HeitorCand/_INTELI_dino_controller/models/evaluation.txt

              precision    recall  f1-score   support

       ruido       0.75      0.90      0.82        10
       pular       1.00      0.90      0.95        10
      abaixa       0.75      0.67      0.71         9

    accuracy                           0.83        29
   macro avg       0.83      0.82      0.82        29
weighted avg       0.84      0.83      0.83        29

Confusion matrix (rows=true, cols=pred), order ['ruido', 'pular', 'abaixa']:
[[9 0 1]
 [0 9 1]
 [3 0 6]]
