HeitorCand/_INTELI_dino_controller/firmware/dino_voice_controller/dsp_tables.h

// Gerado automaticamente por training/export_c_dsp.py — NAO EDITAR A MAO.
// Tabelas do pipeline de DSP (janela Hann, filtros mel, matriz DCT) —
// devem ficar em sincronia com training/dsp.py.
#pragma once

#define DSP_N_FFT 512
#define DSP_N_BINS 257
#define DSP_HOP_LENGTH 256
#define DSP_N_MELS 26
#define DSP_N_MFCC 11
#define DSP_N_FRAMES 61
#define DSP_CLIP_LENGTH 16000

static const float DSP_HANN_WINDOW[512] = {0.00000000f, 0.00003780f, 0.00015118f, 0.00034013f, 0.00060463f, 0.00094463f, 0.00136008f, 0.00185091f, 0.00241706f, 0.00305844f, 0.00377495f, 0.00456648f, 0.00543291f, 0.00637411f, 0.00738995f, 0.00848026f, 0.00964488f, 0.01088363f, 0.01219634f, 0.01358279f, 0.01504278f, 0.01657609f, 0.01818249f, 0.01986173f, 0.02161357f, 0.02343773f, 0.02533393f, 0.02730190f, 0.02934134f, 0.03145194f, 0.03363337f, 0.03588531f, 0.03820742f, 0.04059934f, 0.04306072f, 0.04559118f, 0.04819034f, 0.05085782f, 0.05359319f, 0.05639606f, 0.05926599f, 0.06220255f, 0.06520531f, 0.06827380f, 0.07140756f, 0.07460611f, 0.07786898f, 0.08119567f, 0.08458568f, 0.08803850f, 0.09155359f, 0.09513044f, 0.09876850f, 0.10246722f, 0.10622604f, 0.11004440f, 0.11392171f, 0.11785739f, 0.12185084f, 0.12590148f, 0.13000865f, 0.13417177f, 0.13839021f, 0.14266330f, 0.14699043f, 0.15137093f, 0.15580413f, 0.16028938f, 0.16482598f, 0.16941325f, 0.17405050f, 0.17873703f, 0.18347214f, 0.18825510f, 0.19308519f, 0.19796169f, 0.20288384f, 0.20785092f, 0.21286216f, 0.21791682f, 0.22301412f, 0.22815330f, 0.23333357f, 0.23855416f, 0.24381429f, 0.24911314f, 0.25444993f, 0.25982383f, 0.26523405f, 0.27067977f, 0.27616015f, 0.28167439f, 0.28722161f, 0.29280102f, 0.29841176f, 0.30405295f, 0.30972379f, 0.31542337f, 0.32115087f, 0.32690543f, 0.33268613f, 0.33849216f, 0.34432256f, 0.35017651f, 0.35605314f, 0.36195150f, 0.36787075f, 0.37380999f, 0.37976828f, 0.38574475f, 0.39173850f, 0.39774862f, 0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
0246722f, 0.09876850f, 0.09513044f, 0.09155359f, 0.08803850f, 0.08458568f, 0.08119567f, 0.07786898f, 0.07460611f, 0.07140756f, 0.06827380f, 0.06520531f, 0.06220255f, 0.05926599f, 0.05639606f, 0.05359319f, 0.05085782f, 0.04819034f, 0.04559118f, 0.04306072f, 0.04059934f, 0.03820742f, 0.03588531f, 0.03363337f, 0.03145194f, 0.02934134f, 0.02730190f, 0.02533393f, 0.02343773f, 0.02161357f, 0.01986173f, 0.01818249f, 0.01657609f, 0.01504278f, 0.01358279f, 0.01219634f, 0.01088363f, 0.00964488f, 0.00848026f, 0.00738995f, 0.00637411f, 0.00543291f, 0.00456648f, 0.00377495f, 0.00305844f, 0.00241706f, 0.00185091f, 0.00136008f, 0.00094463f, 0.00060463f, 0.00034013f, 0.00015118f, 0.00003780f, 0.00000000f};
static const float DSP_BIN_FREQS[257] = {0.00000000f, 31.25000000f, 62.50000000f, 93.75000000f, 125.00000000f, 156.25000000f, 187.50000000f, 218.75000000f, 250.00000000f, 281.25000000f, 312.50000000f, 343.75000000f, 375.00000000f, 406.25000000f, 437.50000000f, 468.75000000f, 500.00000000f, 531.25000000f, 562.50000000f, 593.75000000f, 625.00000000f, 656.25000000f, 687.50000000f, 718.75000000f, 750.00000000f, 781.25000000f, 812.50000000f, 843.75000000f, 875.00000000f, 906.25000000f, 937.50000000f, 968.75000000f, 1000.00000000f, 1031.25000000f, 1062.50000000f, 1093.75000000f, 1125.00000000f, 1156.25000000f, 1187.50000000f, 1218.75000000f, 1250.00000000f, 1281.25000000f, 1312.50000000f, 1343.75000000f, 1375.00000000f, 1406.25000000f, 1437.50000000f, 1468.75000000f, 1500.00000000f, 1531.25000000f, 1562.50000000f, 1593.75000000f, 1625.00000000f, 1656.25000000f, 1687.50000000f, 1718.75000000f, 1750.00000000f, 1781.25000000f, 1812.50000000f, 1843.75000000f, 1875.00000000f, 1906.25000000f, 1937.50000000f, 1968.75000000f, 2000.00000000f, 2031.25000000f, 2062.50000000f, 2093.75000000f, 2125.00000000f, 2156.25000000f, 2187.50000000f, 2218.75000000f, 2250.00000000f, 2281.25000000f, 2312.50000000f, 2343.75000000f, 2375.00000000f, 2406.25000000f, 2437.50000000f, 2468.75000000f, 2500.00000000f, 2531.25000000f, 2562.50000000f, 2593.75000000f, 2625.00000000f, 2656.25000000f, 2687.50000000f, 2718.75000000f, 2750.00000000f, 2781.25000000f, 2812.50000000f, 2843.75000000f, 2875.00000000f, 2906.250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
 1.77091205f, 1.77091205f, 0.24107336f, -1.49702156f, -1.94188368f, -0.70920980f, 1.13612950f, 2.00000000f, 1.13612950f, -0.70920980f, -1.94188368f, -1.49702156f, 0.24107336f, 1.77091205f, 1.71156251f, -0.12075699f, -1.82379973f, -1.57436693f, 0.36051008f, 1.90944171f, 1.41421354f, -0.59500611f, -1.96723986f, -1.23343778f, 0.82082564f, 1.99635112f, 1.03467560f, -1.03467560f, -1.99635112f, -0.82082564f, 1.23343778f, 1.96723986f, 0.59500611f, -1.41421354f, -1.90944171f, -0.36051008f, 1.57436693f, 1.82379973f, 0.12075699f, -1.71156251f, 1.64596772f, -0.47863132f, -1.98541772f, -0.92944634f, 1.32624531f, 1.87003243f, 0.00000000f, -1.87003243f, -1.32624531f, 0.92944634f, 1.98541772f, 0.47863132f, -1.64596772f, -1.64596772f, 0.47863132f, 1.98541772f, 0.92944634f, -1.32624531f, -1.87003243f, -0.00000000f, 1.87003243f, 1.32624531f, -0.92944634f, -1.98541772f, -0.47863132f, 1.64596772f};
