HeitorCand/_INTELI_dino_controller/firmware/dino_voice_controller/model_weights.h

// Gerado automaticamente por training/export_c_model.py — NAO EDITAR A MAO.
// Pesos do classificador (14 -> 16 -> 3) exportados de models/model.onnx.
#pragma once

#define MODEL_INPUT_DIM 14
#define MODEL_HIDDEN_DIM 16
#define MODEL_OUTPUT_DIM 3

static const float MODEL_FEATURE_MEAN[14] = {0.06912120f, 0.05374886f, 1060.70336914f, -41.91224289f, 20.66954231f, 3.30957580f, 5.01662731f, 1.32854223f, 1.07099843f, 3.33626580f, 0.09729191f, 2.69106770f, 0.13056268f, 1.40158260f};
static const float MODEL_FEATURE_STD[14] = {0.05550516f, 0.06674842f, 832.20416260f, 71.41362762f, 16.46324539f, 7.28302717f, 4.36978674f, 3.10533094f, 2.97142386f, 2.42597795f, 1.95839226f, 1.97845685f, 1.80596626f, 1.69865310f};
static const float MODEL_W1[224] = {-0.68462336f, 0.83137816f, -0.27663499f, 0.65736639f, -1.14254630f, -1.24790776f, 0.29761100f, 0.75139672f, 0.78998572f, 0.44206744f, -0.39365783f, -0.94104177f, 0.61214894f, 0.19086707f, -0.96814102f, 0.61311495f, 0.59436256f, 0.10916279f, 0.29985192f, -0.23247701f, -0.40611807f, -0.21562888f, 0.30488542f, 0.76631844f, -0.77504510f, -0.56126654f, 0.21959364f, 0.02768652f, 0.42558244f, 0.11142458f, 0.83168095f, -0.30330464f, 1.08849895f, -0.10859705f, -0.19737646f, 0.07138971f, 0.11890364f, 0.55889010f, -0.31737173f, -0.74623841f, 0.20646280f, 0.10793550f, 0.48795804f, -0.16879384f, -0.42175952f, -0.61964291f, 1.21426618f, -0.61936051f, 0.26101136f, 0.03092177f, -0.06524704f, 0.30990130f, -0.41177124f, 1.01031554f, -0.41550484f, 0.67695773f, 0.86868292f, -0.51463675f, 1.13366377f, -0.05458485f, -0.88251406f, 0.44762063f, 0.27979052f, -0.32582387f, -0.16872747f, 0.10479505f, 0.42373091f, -0.97208327f, -0.38683480f, 0.35282680f, 0.57352185f, 0.18639608f, 0.27925628f, -0.48410913f, 0.04929976f, -0.63011038f, -0.60740095f, -0.32758686f, 0.45145875f, -0.52099407f, 0.04641594f, -0.47688428f, 0.53995764f, -0.04050408f, 0.79242593f, -0.04556704f, 0.60421342f, -0.70282650f, 0.00947619f, -0.05764787f, -0.25014800f, -0.40532514f, 0.65974563f, -0.63766855f, -0.09511381f, 0.36447349f, 0.26034635f, -0.34272403f, -0.76957464f, -0.69876343f, -0.70178491f, 0.32221943f, -1.02615774f, 0.45945674f, 0.07316710f, 0.02373385f, 0.07912834f, 0.52190316f, 0.74574751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
static const float MODEL_B2[3] = {0.39390135f, -0.06279805f, -0.24335882f};
