HeitorCand/_INTELI_dino_controller/firmware/dino_voice_controller/feature_extraction.h

// Extração de features (RMS, Zero-Crossing Rate, Spectral Centroid, MFCC),
// espelhando exatamente training/dsp.py e training/features.py em Python —
// mesma FFT de 512 pontos, 26 filtros mel, 11 coeficientes MFCC (ver
// firmware/dsp_tables.h, gerado por training/export_c_dsp.py).
#pragma once

#include <stdint.h>

#include "dsp_tables.h"

#define FEATURE_DIM (1 + 1 + 1 + DSP_N_MFCC)  // RMS + ZCR + centroide + MFCC

// signal deve ter exatamente DSP_CLIP_LENGTH (16000) amostras PCM de 16 bits
// (mesma convenção de um WAV int16 — valor float = amostra / 32768.0).
// outFeatures recebe FEATURE_DIM valores, na ordem
// [RMS, ZCR, centroide, mfcc_0..mfcc_10] — mesma ordem de training/features.py.
void extractFeatures(const int16_t *signal, float outFeatures[FEATURE_DIM]);
