HeitorCand/_INTELI_dino_controller/(commit log)

2026-09-17 Add audio data augmentation (noise, pitch shift, time stretch)
    [augment.py]
2026-09-17 Fix train/test leakage from post-augmentation splitting
    build_dataset augmented each raw clip into 4 correlated variants
    (original + noisy + pitch-shifted + time-stretched) before
    split_dataset randomly partitioned the pooled rows. Augmented
    siblings of the same recording could land on both sides of the
    split, so reported test accuracy reflected near-duplicate leakage
    rather than genuine generalization.
    Restructure training/dataset.py to split at the raw-clip level
    first (split_raw_clips), then only augment the training partition
    (build_features(..., augment=True) for train, augment=False for
    test) via load_raw_clips + build_features. Update train.py's main()
    and training/tests/test_dataset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
    [dataset.py, record_audio.py, train.py]
2026-09-17 Fix code review findings on training pipeline
    - record_audio.py: compute next_clip_index from max existing index + 1
    instead of file count, so deleting a bad take no longer causes the
    next recording to silently overwrite a later good clip.
    - train.py: seed torch before building CommandClassifier in train_model
    so training (and the exported model.onnx) is reproducible.
    - train.py: extract main()'s load->split->augment->train->evaluate logic
    into a standalone run_pipeline(raw_dir) so the wiring is testable.
    - test_train.py: strengthen the class-name test to assert the exact
    classification_report output (with target_names=CLASSES) appears in
    evaluate_model's return value, rather tha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
    [record_audio.py, train.py]
2026-09-17 Retrain model with fixed seed for reproducibility
    Evaluation results unchanged (0.85 accuracy, same confusion matrix);
    model.onnx updated to the post-seed-fix training run. Minor binary
    differences between repeated runs come from CPU thread-level floating
    point non-determinism in BLAS ops, not from the seed itself - accuracy
    and classification decisions are stable across runs.
2026-09-17 Add live microphone test tool with energy-based voice detection
    Continuously listens via the mic, auto-calibrates a silence threshold,
    segments speech by RMS energy (with pre-roll and hangover), and classifies
    each detected utterance as pular/abaixa/ruido using the trained ONNX model.
2026-09-17 Make spectral-shape features gain-invariant to reduce cross-mic mismatch
    Peak-normalize the signal before computing spectral centroid/MFCCs, while
    keeping RMS on the raw signal (it's the one feature meant to carry
    loudness for ruido-vs-speech detection). Training data was recorded via
    iPhone Voice Memos; live testing uses the laptop's built-in mic through
    sounddevice, a different gain/AGC profile. This makes word-identity
    features (centroid/MFCC) invariant to that per-device gain difference.
    Held-out accuracy on the (iPhone-only) test set: 0.80 (down from 0.90) -
    expected tradeoff, since some of the previous accuracy came from an
    amplitude cue that wouldn't have generalized across microphon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
2026-09-17 Expand augmentation with random gain and time-shift variants
    Adds random_gain (simulates different mic/distance gain staging) and
    time_shift (moves where the word sits within the fixed window) to
    augment_signal, going from 4 to 6 variants per raw clip. Both target the
    cross-mic/cross-capture-pipeline generalization gap without needing new
    recordings. Held-out accuracy: 0.85 (up from 0.80 after the gain-invariant
    feature change, on the same iPhone-only test set).
    [augment.py]
2026-09-17 Retrain on batch 4 (only clean single-word clips added)
    Filtered out 11 ambiguous/off-topic transcriptions and 3 compound
    utterances (word + extra chatter) from this noisier recording batch,
    adding only 3 clean pular and 9 clean abaixa clips. Dataset now 133 raw
    clips (52 pular, 63 abaixa, 18 ruido). Accuracy: 0.78 (up from 0.76).
2026-09-17 Add confidence and duration-based rejection to live_test
    Small neural nets are confidently wrong on out-of-distribution input, and
    normal conversation is an effectively infinite category no finite ruido
    dataset can fully cover. Two cheap, no-retraining mitigations, standard
    in keyword-spotting systems: reject to 'ruido' when the top-class
    probability is below 0.6, and reject when the captured utterance is
    too long to be a short command (either it hit the hard capture cap, or
    just ran past 1.2s) - normal speech rarely pauses as quickly as a single
    shouted word does.
    [live_test.py]
2026-09-17 Add zero-crossing rate feature; drop segmented pooling experiment
    Explored feature engineering: tried splitting each clip into 2/3/4 time
    segments and pooling RMS/ZCR/centroid/MFCC per segment (13 -> 28/42/56
    dims) to preserve temporal structure the whole-clip mean collapses away.
    All three segment counts scored worse (74-77%) than the simple whole-clip
    approach (80%) - too much added dimensionality for a 171-clip dataset to
    support. Reverted to whole-clip pooling, but kept the one isolated
    addition that helped in a controlled test: zero-crossing rate (13 -> 14
    features). Accuracy: 0.83 (up from 0.80).
    [features.py]
2026-09-17 Switch live_test to continuous sliding-window classification
    Root cause of missed commands during loud background noise: the old
    design only classified after detecting a silence gap (VAD hangover). If
    background stays loud continuously, RMS never drops below threshold, so
    capture never ends naturally - it only stops by hitting the hard cap,
    which the duration-based rejection then always treated as 'too long to
    be a command', discarding real pular/abaixa said during that time.
    New design removes VAD/calibration entirely: continuously classify the
    most recent 1-second sliding window on every audio chunk, rely on
    confidence-threshold rejection only (no duration heuristic - every
    window is alwa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
    [live_test.py]
2026-09-17 Add calibrated silence floor to live_test to stop spontaneous false triggers
    Root cause: after switching to continuous sliding-window classification,
    every window gets classified unconditionally, including near-silent
    ones. Genuine digital silence is out of the training distribution (no
    real recording is ever perfectly silent) and the model can extrapolate
    confidently wrong on it - e.g. all-zeros classifies as 'pular' at 99.9%
    confidence.
    Adds calibrate_min_rms(): a one-time ambient noise measurement at
    startup, used only as a 'skip classification entirely below this floor'
    gate (not a stateful VAD that waits for a silence gap, which is what
    caused the earlier loud-background bug). This kee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
    [live_test.py]
2026-09-17 Revert live_test to VAD hangover design (requested)
    Reverts training/live_test.py and its tests to the state before the
    sliding-window experiment (commit 9b18c4f), restoring the pre-roll +
    hangover + duration/confidence rejection design. The sliding-window
    approach traded one problem for another and the request was to go back
    to this version rather than keep iterating on it.
    [live_test.py]
2026-09-18 Add I2S microphone capture test sketch for ESP32 + INMP441
    Standalone diagnostic sketch (Arduino framework) to verify the INMP441
    wiring and I2S read path before building the full FreeRTOS task
    architecture. Reads 32-bit I2S samples, shifts to the INMP441's useful
    bit range, and prints RMS to Serial so the mic can be verified with a
    handclap/voice test.
2026-09-18 Export trained model weights to a C header for the ESP32 port
    training/export_c_model.py reads the Gemm layer weights/biases from
    models/model.onnx plus the feature normalization stats, and writes them
    as static const float arrays in firmware/model_weights.h. Re-run this
    script any time the model is retrained to regenerate the header.
2026-09-18 Add C port of the MLP forward pass for the ESP32
    Verified numerically against the Python/onnxruntime model on a random
    14-dim feature vector: logits match to 1e-5, same predicted class.
    Normalize -> Linear(14,16) -> ReLU -> Linear(16,3) -> softmax, using the
    weights from firmware/model_weights.h.
2026-09-18 Add custom FFT-based DSP pipeline for spectral centroid and MFCC
    Replaces librosa's desktop-scale defaults (2048-point FFT, 128 mel bands)
    with an embedded-appropriate configuration (512-point FFT, 26 mel bands,
    256-sample hop) built from scratch: Hann windowing, HTK mel scale
    triangular filterbank, DCT-II. This is the exact algorithm that gets
    ported to C for the ESP32 - controlling both sides means we only need
    Python and C to agree with each other, not with librosa's internals.
    [dsp.py]
2026-09-18 Retrain with the embedded-sized DSP pipeline (512-FFT/26-mel)
    Wires training/dsp.py into features.py, replacing librosa entirely for
    spectral centroid and MFCC (also replaced librosa's zero_crossing_rate
    with an equivalent custom implementation, for the same reason: keep
    training and firmware using the exact same, C-portable formulas).
    extract_features now computes the FFT frame magnitudes once and reuses
    them for both centroid and MFCC, instead of recomputing.
    Accuracy: 0.81 (down slightly from 0.84) - expected trade-off for using
    a 512-point FFT / 26 mel bands instead of librosa's 2048/128 defaults,
    which would be impractical to port to the ESP32.
    [features.py, model_weights.h]
2026-09-18 Add C port of the full feature extraction pipeline (FFT/MFCC/centroid)
    - fft.cpp: radix-2 Cooley-Tukey FFT (512-point), verified against
    numpy.fft.rfft on a 2000Hz test tone (max relative error ~7e-7, exact
    peak bin match).
    - feature_extraction.cpp: RMS, ZCR, spectral centroid, and 11 MFCCs,
    mirroring training/dsp.py + training/features.py exactly (same Hann
    window, mel filterbank, DCT matrix, exported by
    training/export_c_dsp.py into firmware/dsp_tables.h).
    - Verified end-to-end against training/features.py's extract_features()
    on a real training clip: all 14 feature values match to 1e-4 or better.
    This closes the loop from raw audio to a feature vector the C model
    (model_infer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
    [dsp_tables.h, export_c_dsp.py, feature_extraction.cpp, feature_extraction.h, fft.cpp, fft.h]
2026-09-18 Reorganize firmware/ into a proper Arduino sketch folder
    Arduino IDE only auto-compiles .cpp/.h files that live in the SAME
    folder as the .ino you open. The DSP/model files were sitting loose in
    firmware/, one level above any sketch - opening i2s_mic_test/ wouldn't
    have seen them, and there was no valid sketch folder for the eventual
    integrated firmware at all.
    Moves dsp_tables.h, fft.{h,cpp}, feature_extraction.{h,cpp},
    model_weights.h, model_inference.{h,cpp} into a new
    firmware/dino_voice_controller/ sketch folder, alongside a minimal
    dino_voice_controller.ino (just includes the headers and prints
    FEATURE_DIM/MODEL_INPUT_DIM for now - the real FreeRTOS task wiring is
    next). Updated train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
    [dino_voice_controller.ino, dsp_tables.h, export_c_dsp.py, export_c_model.py, feature_extraction.cpp, feature_extraction.h, fft.cpp, fft.h]
2026-09-18 Wire up the full 4-task FreeRTOS architecture in the main sketch
    Task 1 (alta): captura I2S continua com buffer duplo (int16, PCM),
    sincronizado por 2 semaforos binarios (nunca sobrescreve um buffer que a
    Task 2 ainda esta lendo).
    Task 2 (media): extracao de features, libera o semaforo do buffer assim
    que termina de le-lo, envia features por fila.
    Task 3 (baixa): forward-pass do modelo + threshold de confianca +
    cooldown entre comandos, envia comando por fila.
    Task 4 (baixa): aciona o servo correspondente + LED/buzzer, atualiza o
    log de latencia (unico recurso protegido por mutex, ja que nao passa
    pelas filas).
    Reduz uso de RAM: buffers de captura de float (64KB cada) para int16 PCM
    (32KB c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
    [dino_voice_controller.ino, feature_extraction.cpp, feature_extraction.h]
2026-09-18 Add ambient RMS calibration to stop firmware over-triggering on silence
    Real-hardware testing showed the firmware confidently classifying
    near-silent windows as PULAR on almost every cycle - the same
    out-of-distribution overconfidence bug found and fixed in
    training/live_test.py (calibrate_min_rms), but never ported here. The
    confidence threshold alone doesn't catch it, since the model can be
    >90% confident on pure/near silence it never saw a clean example of
    during training.
    calibrateAmbientRms() blocks in setup() for ~1s measuring ambient RMS
    via a direct I2S read (before any task exists), sets a floor
    (ambient * 3, minimum 0.01); detectionTask now checks the RMS feature
    already computed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
    [dino_voice_controller.ino]
2026-09-18 Remove the ambient RMS floor gate for now (requested)
    Real-hardware calibration measured 0.3281 RMS during supposed silence -
    far too high for real acoustic silence, and it made the floor (~0.98)
    essentially unreachable even by real speech, so nothing was being
    detected at all. This needs investigation (INMP441 wiring/config or the
    I2S sample scaling assumption) before the floor gate can be reinstated.
    Left a TODO comment explaining why it's gone and what to check.
    [dino_voice_controller.ino]
2026-09-18 Add temporary debug print (RMS/ZCR/probabilities) to diagnose silence bug
    Prints every window's RMS, ZCR, and class probabilities to Serial,
    regardless of whether a command fires. Needed to see whether the
    silence-triggers-PULAR issue is the model being confidently wrong (same
    overconfidence problem as before) or something stranger in the captured
    signal itself. Remove once diagnosed.
    [dino_voice_controller.ino]
2026-09-18 Add fixed RMS floor (0.15) based on real bench data, raise confidence threshold
    Debug log from real hardware showed ambient/silence RMS fluctuating
    0.02-0.10 on this specific mic/room, with the model occasionally
    classifying it as PULAR with high confidence (up to 0.999) - the same
    overconfidence-outside-training-distribution issue as before, now with
    real numbers instead of a guess.
    Fix: a FIXED floor (0.15, comfortably above the observed ambient
    ceiling) instead of the earlier single-sample calibration (which was
    vulnerable to one noisy 1s reading skewing the whole threshold - that's
    what happened with the 0.3281 reading that made everything unreachable).
    Also raised CONFIDENCE_THRESHOLD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
    [dino_voice_controller.ino]
2026-09-18 Add ESP32-to-PC recording pathway to close the mic-domain gap for real
    Debug data confirmed the same mic-domain bias problem on the ESP32 +
    INMP441 as with earlier mics (iPhone/laptop/Common Voice): loud PULAR
    bias even when the user says 'abaixa'. Every prior mitigation (gain
    invariance, augmentation, cross-speaker MSWC data) helped in aggregate
    but each new microphone still needs some of its own real data - this
    finally builds the pathway to get it directly from the deployment mic.
    - firmware/esp32_record/esp32_record.ino: waits for a 'r' trigger byte
    over Serial, captures exactly 1s (16000 int16 PCM samples) via I2S,
    replies with a 'REC1' header + the raw bytes. Compiles clean (21%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
    [esp32_record.ino, record_from_esp32.py]
2026-09-18 Make ESP32 recording protocol robust to boot-time serial garbage
    The ESP32 ROM bootloader prints diagnostics at a different baud rate
    right after reset (visible in earlier Serial output:
    'load:0x40080400,len:3500 entry 0x400805b4'), which can land as garbled
    bytes on the line before the sketch's own 115200-baud output starts.
    Real hardware test hit exactly this: parse_clip_response got header
    b'\x00\xff\x00\xff' instead of REC1.
    read_until_magic() scans and discards bytes one at a time until it
    finds the REC1 marker (bounded by max_scan_bytes, raises ValueError if
    exceeded; TimeoutError if the stream ends first), instead of assuming
    the first 4 bytes read are always the real header. Unit te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
    [record_from_esp32.py]
2026-09-19 Retrain with real INMP441 data recorded via the ESP32 (closes mic gap)
    Added 15 pular, 13 abaixa, 19 ruido clips recorded directly through the
    deployment microphone (esp32_record.ino + record_from_esp32.py), on top
    of the existing dataset. Dataset now 331 raw clips (136 pular, 123
    abaixa, 72 ruido). Accuracy: 0.82 on a larger test set (67 clips) that
    now includes real INMP441-captured held-out examples too - crucially,
    pular/abaixa confusion is now balanced (5 each direction) instead of the
    one-sided 'everything looks like pular' bias seen in live hardware
    testing, suggesting the real mic data is correcting that domain bias.
    Regenerated firmware/dino_voice_controller/model_weights.h and veri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
    [model_weights.h]
2026-09-19 Lower RMS floor to 0.09 - real speech measured only slightly above ambient
    Real bench test: user's spoken 'abaixa' measured RMS=0.1019, below the
    previous 0.15 floor entirely (nothing was being detected). Ambient noise
    in this environment/mic distance tops out around ~0.08-0.10 too, so the
    SNR margin between speech and ambient is thin right now - no static
    threshold gives a comfortable separation. Lowered to 0.09 as a
    compromise; the real fix is speaking louder/closer to the mic, which
    this alone can't substitute for.
    [dino_voice_controller.ino]
2026-09-19 Deep-clean dataset: remove 54 mislabeled/garbage clips found via full Whisper audit
    Full-dataset audit (not just the recent batch) revealed the MLCommons
    MSWC data has a meaningfully higher mislabeling rate than assumed - many
    'pula'/'pular'/'abaixo' clips were actually garbage, silence, or a
    completely different word (e.g. 'Baixo'/'Baixa' without the leading 'a',
    'umbrella', English fragments), likely from imperfect forced-alignment
    in the source corpus. Also caught 6 ESP32-recorded pular clips with the
    same problem, plus a few of our own earlier phonetic-reclassification
    near-misses ('Bula'/'Fula'/'Mula') that we'd already learned hurt more
    than they help.
    Removed: 31 pular clips, 19 abai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
    [model_weights.h]
2026-09-19 Record ESP32 audio into a staging folder, not directly into the dataset
    training/data/esp32_raw/<class>/ instead of training/data/raw/<class>/.
    Given how much mislabeled/garbage content turned up in past batches
    (some already reviewed via Whisper, some caught only in a later full
    audit), recordings now land somewhere reviewable before being merged
    into the official training set, rather than immediately mixing in.
2026-09-19 Merge curated ESP32 staging batch into training set (81% accuracy)
    Reviewed 41+41+31 staged ESP32 recordings via Whisper. Key judgment
    call: for 'pular', kept clips Whisper transcribed as 'Bula'/'BULAR'/
    'Mula' rather than discarding them like earlier phonetic-near-miss
    cleanups - in this deliberate recording session (user pressed record
    specifically to say 'pular'), a mishearing is much more likely to be
    this exact mic's rendering of the plosive 'p' sound than a genuine
    off-topic recording, and that's precisely the mic-specific signal we
    need more of. Only removed clearly wrong/empty/garbage content (3
    pular clips) and abaixa clips truncated mid-word by the 1s window (7
    clips) - a real tech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
    [model_weights.h]
2026-09-19 Switch to an ESP32-only trained model (single-domain, no mic mismatch)
    Diagnostic experiment confirmed the domain-mismatch hypothesis clearly:
    training and testing purely within the ESP32/INMP441 domain gives
    pular precision/recall of 1.00/0.90, versus the mixed-source model's
    0.82/0.82 - a large, direct improvement once the mic-domain variance is
    removed from both sides of the split.
    Moved the 230 non-ESP32 clips (iPhone, laptop, MSWC) to
    training/data/raw_archive_mixed_sources/ (kept, not deleted - still
    gitignored, available if we want to blend sources again later) and
    retrained on just the 142 real ESP32-recorded clips (49 pular, 43
    abaixa, 50 ruido) through the normal pipeline. Accurac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
2026-09-19 Reduce servo press angle from 90 to 30 degrees
    Requested: servo was moving too much for a simple key press. Reset-to-
    initial-position on boot was already implemented (servo.write(0) right
    after attach() in setup()).
    [dino_voice_controller.ino]
2026-09-19 Give each servo its own released/pressed angles (abaixa moves the other way)
    Servos are mounted in opposite orientations. Pular still goes 0 -> 30;
    abaixa now goes 180 -> 150, so both physically press downward on their
    own side instead of sharing one direction. pressServo() takes explicit
    released/pressed angles per call instead of relying on shared globals.
2026-09-19 Set both servos to 25 degrees of travel (requested)
    Pular: 0 -> 25. Abaixa: 180 -> 155 (same 25-degree amount, opposite
    direction, matching how the servos are physically mounted).
2026-09-19 Fix abaixa servo: same 0-29 range as pular, reversed direction
    Previous fix moved abaixa to the 150-180 range entirely, which was
    wrong - it just needed to traverse the same small range as pular but in
    the opposite rotational direction (released=29, pressed=0), since it's
    mounted mirrored relative to pular's servo (released=0, pressed=29).
    Also bumped travel from 25 to 29 degrees per request.
    [dino_voice_controller.ino]
2026-09-19 Match abaixa servo angles to pular (0/30) - mounting inverted in hardware instead
    User is physically flipping the abaixa servo's mounting orientation, so
    both servos now use identical released=0/pressed=30 logic in software.
    [dino_voice_controller.ino]
2026-09-19 Set pular servo travel to 32 degrees
2026-09-19 Increase servo press hold time to 300ms for both pular and abaixa
    Made hold time configurable per servo (SERVO_PULAR_PRESS_HOLD_MS /
    SERVO_ABAIXA_PRESS_HOLD_MS) instead of one shared constant. Started with
    pular only (300ms, up from 150ms), then applied the same to abaixa.
2026-09-19 Set abaixa servo hold time to 1 second (pular stays at 300ms)
2026-09-19 Set abaixa servo travel to 29 degrees
2026-09-19 Set pular servo travel to 33 degrees
2026-09-19 Set abaixa servo travel to 27 degrees
2026-09-19 Set pular servo travel to 34 degrees
2026-09-19 Set abaixa servo travel to 25 degrees
2026-09-19 Set abaixa servo travel to 26 degrees
2026-09-19 Set pular servo travel to 35 degrees
2026-09-19 Switch spoken commands from Portuguese to English (up/down)
    Test with Google Speech Commands (200 up, 200 down, plain background
    noise) hit 86% accuracy on 101 held-out clips - a large, clean,
    purpose-built dataset outperforms our messy multi-source Portuguese one
    by a wide margin, with far more statistical confidence (thousands of
    speakers vs our couple dozen).
    Kept internal class names as pular/abaixa (they represent the GAME
    ACTION - jump/duck - not the spoken word) to avoid renaming across the
    whole codebase under time pressure; only the audio data and user-facing
    strings changed. training/data/raw/{pular,abaixa} now hold 300 GSC
    'up'/300 GSC 'down' clips each; ruido keeps the existing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
    [dino_voice_controller.ino, live_test.py, model_weights.h]
2026-09-19 Revert to Portuguese (pular/abaixa) trained on real ESP32 data
    Requested: go back to the PT-BR ESP32-only dataset instead of the
    English up/down GSC experiment. training/data/raw/{pular,abaixa}
    restored from the archive (49 pular, 43 abaixa, unchanged 50 ruido).
    Retrained: 0.83 accuracy on 29 held-out clips, identical to the earlier
    ESP32-only run (deterministic). Reverted Serial/live_test prompts back
    to 'pular'/'abaixa'. The English GSC dataset stays in
    /tmp/gsc_experiment if we want to revisit it.
    [dino_voice_controller.ino, live_test.py, model_weights.h]
2026-09-19 Add RTOS task diagram (Mermaid + SVG) and technical report
    docs/diagrama_rtos.md: task/queue/semaphore/mutex architecture as a
    Mermaid flowchart, plus a table explaining why each synchronization
    mechanism exists. Also exported to docs/diagrama_rtos.svg via
    mermaid-cli, as a standalone image in case the grader doesn't render
    Mermaid code blocks.
    docs/relatorio_tecnico.md: covers architecture, feature/model pipeline,
    the mic-domain-mismatch story (the project's main technical challenge),
    latency breakdown with real bench measurements, offline accuracy
    results, and a discussion of what worked/limitations/future work.
    Leaves marked placeholders for a hardware photo and a demo video, to be
    fille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
2026-09-19 Rewrite technical report as a chronological logbook (diario de bordo)
    Restructured from a numbered-sections report into a day-by-day account
    of what was actually tried, found, and fixed (16-19/09), including the
    dead ends (segmented features, English GSC switch) - not just the final
    polished state. Keeps the final architecture/results/latency summary at
    the end, plus the image/video placeholders.
2026-09-19 Remove date headers from the logbook, structure as a continuous flow
    Replaced day-by-day (16-19/09) headers with topic-based section titles
    that follow the same chronological order the work actually happened in
    (idea -> training pipeline -> mic mismatch -> firmware -> mismatch again
    on hardware -> data cleanup/decisive experiment -> English detour ->
    hardware tuning), reading as one narrative instead of a dated log.
2026-09-20 Use rendered SVG images instead of Mermaid code blocks in the diagram doc
    Mermaid code blocks only render as diagrams on viewers that support it
    (GitHub, some markdown tools); embedding the actual SVG files works
    everywhere. Rendered the priority-flow diagram to SVG too
    (diagrama_prioridades.svg) and swapped both mermaid blocks in
    diagrama_rtos.md for image embeds.
2026-09-20 Remove buzzer, use onboard LED (GPIO2) instead of external LED/buzzer
    No buzzer hardware available. Instead of dropping the alert requirement
    entirely, switched the LED to the ESP32 DevKit's built-in LED (GPIO2 on
    most boards), which needs no extra components. Updated alert() and
    setup() to drop all buzzer code, updated the RTOS diagram SVG and
    report text to match. Verified firmware still compiles (25% flash / 29%
    RAM).
    [dino_voice_controller.ino]
2026-09-20 Add hardware assembly photos to the technical report
    Converted the 4 HEIC photos to JPEG and resized to 1200px width
    (2.4-2.7MB -> ~500KB each) for reasonable repo size. Shows the full
    bench setup (laptop running the Dino game + servos + breadboard), a
    close-up of the ESP32/INMP441 circuit, and close-ups of the two SG90
    servos mounted on the MDF strip over the keyboard. Filled in the image
    placeholder in relatorio_tecnico.md with all four, captioned.
2026-09-20 Clean up dead code found in a full pyflakes audit of training/*.py
    Fixed an f-string with no placeholders (export_c_dsp.py) and removed an
    unused onnx.load() call plus unused Path/torch imports in
    test_export_c_model.py. No other unused imports or dead code found
    across the whole training/ package - every module is imported by at
    least one other module or is a standalone CLI entry point.
    [export_c_dsp.py]
2026-09-20 Add project README and revise diario tone to sound like my own writing
    The diario had gotten too polished and repetitive in phrasing to read as
    something I actually wrote under time pressure, so I loosened the voice
    and cut back on the "clause - explanation" pattern that kept repeating.
2026-09-20 Add test_detector.py and revise relatorio tone
    Adds the "script que simula anomalias e mede performance" deliverable
    that was still missing: training/test_detector.py replays the held-out
    test clips through the detection pipeline, times feature extraction and
    inference separately, and applies the same RMS-floor + confidence-
    threshold decision the firmware uses, instead of a raw argmax. Also
    found and documented a real issue while building it: MIN_RMS_FLOOR
    rejects about half of the offline test clips, so accuracy under the full
    firmware decision logic (79%) is lower than train.py's raw-argmax
    evaluation (83%).
    Also revised the relatorio's tone to sound like my own writing rather
    than a gen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
    [test_detector.py]
2026-09-20 Version the training dataset instead of gitignoring it
    Tracks training/data/raw/ (final 142-clip ESP32-only dataset used by the
    current model), training/data/esp32_raw/ (staging recordings from the
    ESP32) and training/data/raw_archive_mixed_sources/ (the intermediate
    iPhone/notebook + MLCommons MSWC dataset from earlier experiments,
    discarded from the final model but referenced in the diario/relatorio).
    The MSWC-derived clips are CC-BY 4.0, already attributed in
    docs/relatorio_tecnico.md section 9.
2026-09-20 Add circuit photo to the README
